baobuibk/SpaceLiinTech_BEE_1012_LDA_HW_V1.1/03_BOM/Satellite_4U_Laser_Int_Ext_V120.xlsx

Name | Description | Designator | Quantity | Library Name | Footprint | Manufacturer 1 | Manufacturer Part Number 1
0.01uF/16V | CAP CER 10000PF 50V X7R 0603 | C1 | 1 | LABLIB.SchLib | CAP_C_1608X80 | Samsung Electro-Mechanics | CL10B103KB8NNNC
0.22uF/25V | CAP CER 0.22UF 25V X7R 0603 | C2, C4, C5, C10, C16, C20, C23, C25, C26, C33, C43, C49, C51, C53, C55, C58, C59, C60 | 18 | LABLIB.SchLib | CAP_C_1608X80 | Samsung Electro-Mechanics | CL10B224KA8NNNC
1k | RES SMD 1K OHM 1% 1/10W 0402 | R1, R5 | 2 | LABLIB.SchLib | RES_C_1005X40 | Panasonic | ERJ2RKF1001X
1k | RES SMD 1K OHM 1% 1/10W 0603 | R25, R26 | 2 | LABLIB.SchLib | RES_C_1608X60 | Panasonic | ERJ-3EKF1001V
1M | RES SMD 1M OHM 1% 1/10W 0402 | R29, R31 | 2 | LABLIB.SchLib | RES_C_1005X40 | Panasonic | ERJ-2RKF1004X
1N4148W-TP | DIODE STANDARD 100V 150MA SOD123 | D10, D11, D12, D13, D14, D15, D16, D17, D18, D19, D20, D21, D22, D23, D24, D25, D26, D27, D28, D29, D30, D31, D32, D33, D36, D37, D38, D39, D40, D41, D42, D43 | 32 | LASER_LIB_SCHE.SchLib | SOD23 | MCC | 1N4148W-TP
3.24k | RES 3.24K OHM 1% 1/16W 0402 | R4 | 1 | LABLIB.SchLib | RES_C_1005X40 | Vishay | CRCW04023K24FKED
4.7k | RES SMD 4.7K OHM 1% 1/10W 0603 | R8, R12, R13, R38, R39, R40, R41, R42, R43, R44, R45, R46, R47 | 13 | LABLIB.SchLib | RES_C_1608X60 | Panasonic | ERJ3EKF4701V
5.1k | RES 5.1K OHM 1% 1/10W 0603 | R28 | 1 | LABLIB.SchLib | RES_C_1608X60 | Yageo Group | RC0603FR-075K1L
7.5k | RES SMD 7.5K OHM 0.1% 1/10W 0603 | R11 | 1 | LABLIB.SchLib | RES_C_1608X60 | Panasonic | ERA3ARB752V
10k | RES SMD 10K OHM 1% 1/10W 0402 | R2, R27, R30 | 3 | LABLIB.SchLib | RES_C_1005X40 | Panasonic | ERJ-2RKF1002X
10k | RES SMD 10K OHM 1% 1/10W 0603 | R9, R16, R18, R23 | 4 | LABLIB.SchLib | RES_C_1608X60 | Panasonic | ERJ-3EKF1002V
10R/1% | RES 10 OHM 1% 1/10W 0603 | R24, R49 | 2 | LASER_LIB_SCHE.SchLib | RES_SMD_0603_SHUNT | Yageo Group | RC0603FR-0710RL
40.2R/1% | RES SMD 40.2 OHM 1% 1/10W 0603 | R48 | 1 | LASER_LIB_SCHE.SchLib | RES_SMD_0603_SHUNT | Panasonic | ERJ3EKF40R2V
47k | RES SMD 47K OHM 1% 1/10W 0603 | R10, R14, R19, R20 | 4 | LABLIB.SchLib | RES_C_1608X60 | Panasonic | ERJ-3EKF4702V
47uF/20V | CAP TANT 47UF 10% 20V 2312 | C3, C6, C17, C18, C19, C21 | 6 | LASER_LIB_SCHE.SchLib | CAP TANT 2312 | KYOCERA AVX | TAJC476K020RNJ
51R/1% | RES SMD 51 OHM 1% 1/10W 0603 | R6, R21 | 2 | LASER_LIB_SCHE.SchLib | RES_SMD_0603_SHUNT | Panasonic | ERJ3EKF51R0V
100k | RES SMD 100K OHM 1% 1/10W 0603 | R7, R17 | 2 | LABLIB.SchLib | RES_C_1608X60 | Panasonic | ERJ3EKF1003V
140R | RES SMD 140 OHM 0.1% 1/10W 0603 | R15, R22 | 2 | LABLIB.SchLib | RES_C_1608X60 | Panasonic | ERA3AEB1400V
221R/1% | RES SMD 221 OHM 1% 1/10W 0603 | R3 | 1 | LASER_LIB_SCHE.SchLib | RES_SMD_0603_SHUNT | Panasonic | ERJ3EKF2210V
470pF/50V | CAP CER 470PF 50V X7R 0603 | C9, C14 | 2 | LABLIB.SchLib | CAP_C_1608X80 | Samsung Electro-Mechanics | CL10B471KB8NNNC
2200pF/50V | CAP CER 2200PF 50V X7R 0603 | C22, C24 | 2 | LABLIB.SchLib | CAP_C_1608X80 | Samsung Electro-Mechanics | CL10B222KB8NNNC
0532611171 | CONN HEADER SMD R/A 11POS 1.25MM | J1, J2 | 2 | LABLIB.SchLib | MOLEX_0532611171 | Molex | 53261-1171
ADG1414BRUZ | IC SW SPST-NOX8 11.5OHM 24TSSOP | U3, U8, U9, U10 | 4 | LASER_LIB_SCHE.SchLib | TSSOP24 | Analog Devices | ADG1414BRUZ
BLM18PG121SN1D | FERRITE BEAD 120 OHM 0603 1LN | FB1, FB2 | 2 | LABLIB.SchLib | IND_C_1608X60 | Murata | BLM18PG121SN1D
CLP-111-02-X-D | CONN RCPT 22POS 0.05 GOLD SMD | J3 | 1 | LASER_LIB_SCHE.SchLib | SAMTEC_CLP-111-02-X-D | Samtec | CLP-111-02-G-D
DMP3098L-7 | DMP3098L-7 | Q1, Q2 | 2 | LASER_LIB_SCHE.SchLib | SOT23-3-132 | Diodes Inc. | DMP3098L-7
hole_space |  | H1, H2, H3, H4, H5, H6, H7, H8 | 8 | IFBschelib.SchLib | HEX-M3_NoVia_Smaller
INA139 | IC CURRENT MONITOR 0.5% SOT23-5 | U4, U6 | 2 | LASER_LIB_SCHE.SchLib | SOT23-5 | Texas Instruments | INA139NA/250
KDZLVTFTR51 | DIODE ZENER 51V 1W SOD123FL | DZ1, DZ2 | 2 | LABLIB.SchLib | SOD3717X145N | ROHM | KDZLVTFTR51
LaserDiode | LASER DIODE 850NM 1.5MW TO46 | LD1, LD2, LD3, LD4, LD5, LD6, LD7, LD8, LD9, LD10, LD11, LD12, LD13, LD14, LD15, LD16, LD17, LD18, LD19, LD20, LD21, LD22, LD23, LD24 | 24 | LASER_LIB_SCHE.SchLib | OPV302 | Optek | OPV302
LaserDiode | 650NM RED SINGLE MODE LASER DIOD | LD25, LD26, LD27, LD28, LD29, LD30, LD31, LD32 | 8 | LASER_LIB_SCHE.SchLib | RLD65NZX1 | ROHM | RLD65NZX1-00A
LED_RED | LED RED CLEAR 0603 SMD | D3 | 1 | LASER_LIB_SCHE.SchLib | LED_0603 | Würth Elektronik Midcom | 150060RS75000
LED_YELLOW | LED YELLOW CLEAR 0603 SMD | D2 | 1 | LASER_LIB_SCHE.SchLib | LED_0603 | Würth Elektronik Midcom | 150060YS75000
MCP4902-E/ST | IC DAC 8BIT 14-TSSOP | U2, U12 | 2 | LASER_LIB_SCHE.SchLib | TSSOP14 | Microchip | MCP4902-E/ST
OPA2192 | IC OPAMP GP 2 CIRCUIT 8SOIC | U5, U7 | 2 | LASER_LIB_SCHE.SchLib | SO8 | Texas Instruments | OPA2192IDR
S2303 | TVS DIODE 3.3VWM 8VC SOT233 | D4, D5, D6, D7, D8, D9, D34, D35, D44 | 9 | LASER_LIB_SCHE.SchLib | SOT23-3-132 | Sangdest Microelectronics | S2303
SRP7050TA-220M | FIXED IND 22UH 2.5A 170 MOHM SMD | L1 | 1 | LABLIB.SchLib | PSM6050 | Bourns | SRP7050TA-220M
SS54 | DIODE SCHOTTKY 40V 5A SMA | D1 | 1 | LABLIB.SchLib | DO-214AC_SMA | Multicomp | SS54
TPS7A4533DCQR | IC REG LIN 3.3V 1.5A SOT-223-6 | U11 | 1 | LASER_LIB_SCHE.SchLib | SOT223-6 | Texas Instruments | TPS7A4533DCQR
TPS5430DDAR | IC REG BUCK ADJ 3A 8SOPWR | U1 | 1 | LASER_LIB_SCHE.SchLib | CONV_TPS5430DDAR | Texas Instruments | TPS5430DDAR
Note |  | Total | 178
Tô vàng: chưa có ở các board trước
Tô hồng: thay thế so với BOM cũ
