baobuibk/SpaceLiinTech_BEE_1012_LDA_HW_V1.1/08_3D/Satellite_4U_Laser_Int_Ext_V130.step

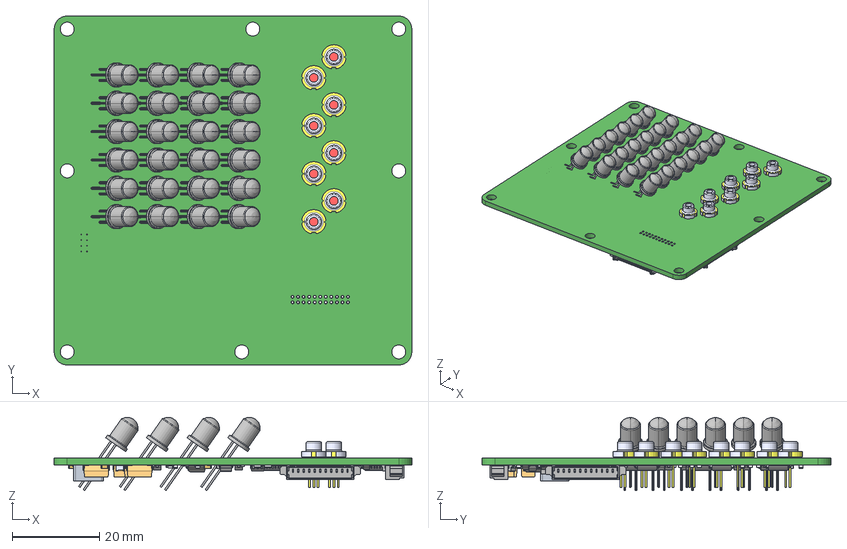
[picture p1: CAD file, 2026-09-09]
08_3D/Satellite_4U_Laser_Int_Ext_V130.step
82.0 x 80.0 x 16.8 mm
RES_0402 x 8
User Library-SMD RESISTOR-1 (3) x 6
532611171_RGB8421504 x 2
Mid Body x 31
Mark x 31
TAJC107K016RNJ x 6
LEAD x 5
LEAD_WIDE
CLP-111-2-G-DTRM
C-106-22-1-G-11_Pin x 2
User Library-IPC SO x 2
SW3DPS-SOT-23-DEFAULT x 11
pin x 32
pin(Mirror) x 32
icbody x 32
Laser diode ML101J25 x 8
SMAJ12A-13-F
User Library-IPC SO_2628500713 x 4
CircuitWorks-SO-8 (PIC12FXXX) x 2
User Library-SOT-23-5_pin_SOT_sot-23-6_1 x 10
User Library-SOT-23-5_body_sot23-6_1 x 2
OPV302_RGB8421504 x 24
SRP7050TA
housing x 2
cover x 2
base x 4
Polarity Mark x 2
