baobuibk/SpaceLiinTech_BEE_1012_LDA_HW_V1.1/(list of files, cad)

Other CAD files:
08_3D/Satellite_4U_Laser_Int_Ext_V12.step
