baobuibk/SpaceLiinTech_BEE_1012_LDA_HW_V1.1/02_Schematic_pdf/Satellite_4U_Laser_Int_Ext_V130.pdf

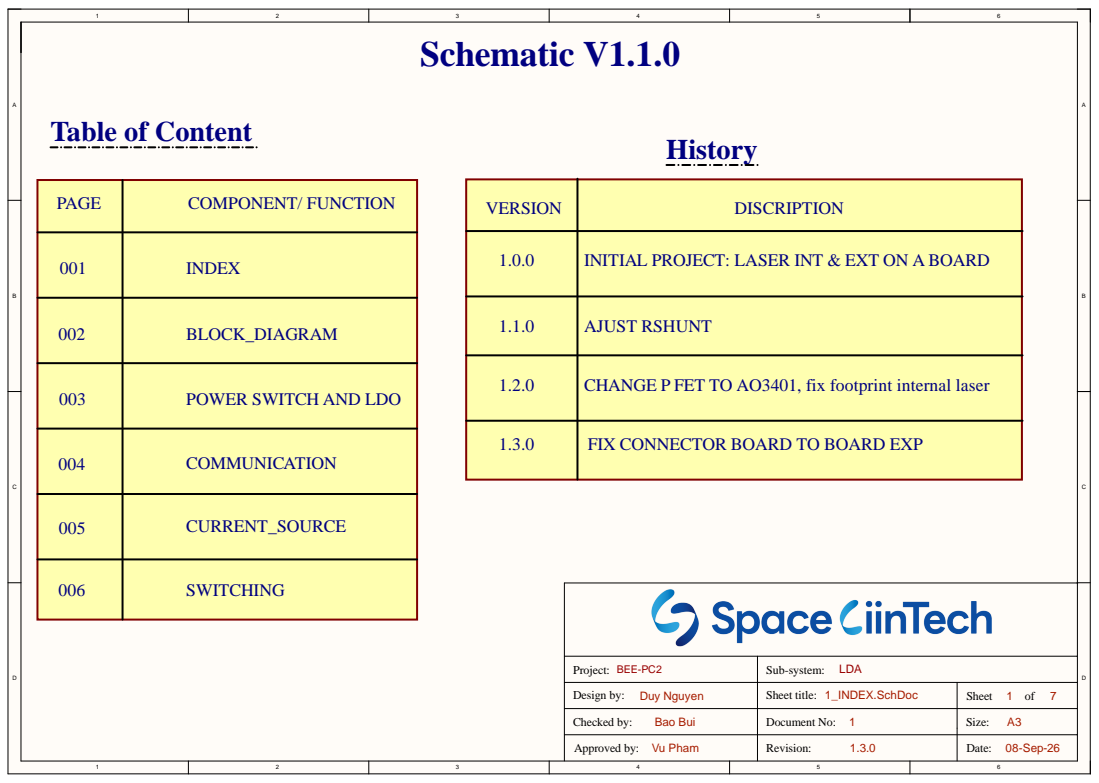
[picture p9: page 1]

INITIAL PROJECT: LASER INT & EXT ON A BOARD

1.2.0 | CHANGE P FET TO AO3401, fix footprint internal laser

003 | POWER SWITCH AND LDO

1.3.0 | FIX CONNECTOR BOARD TO BOARD EXP

004 | COMMUNICATION

005 | CURRENT_SOURCE

006 | SWITCHING

Project: BEE-PC2 | LDA Sub-system:

Design by: Duy Nguyen | Sheet title: 1_INDEX.SchDoc | Sheet 1 of 7

Checked by: Bao Bui | Document No: 1 | Size: A3

Approved by: Vu Pham | Revision: 1.3.0 | Date: 08-Sep-26

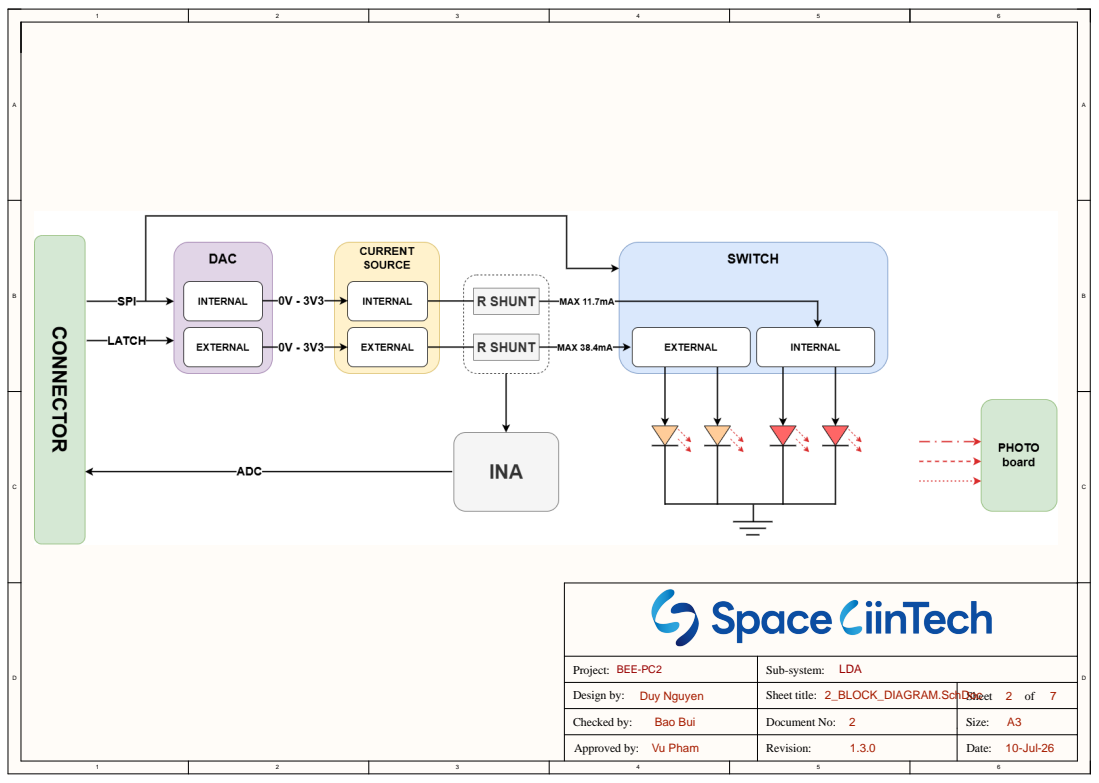
[picture p10: page 2]

BEE-PC2 Project: | LDA Sub-system:

Design by: Duy Nguyen | Sheet title: 2_BLOCK_DIAGRAM.SchDoc | Sheet 2 of 7

Checked by: Bao Bui | Document No: 2 | Size: A3

Date: 10-Jul-26

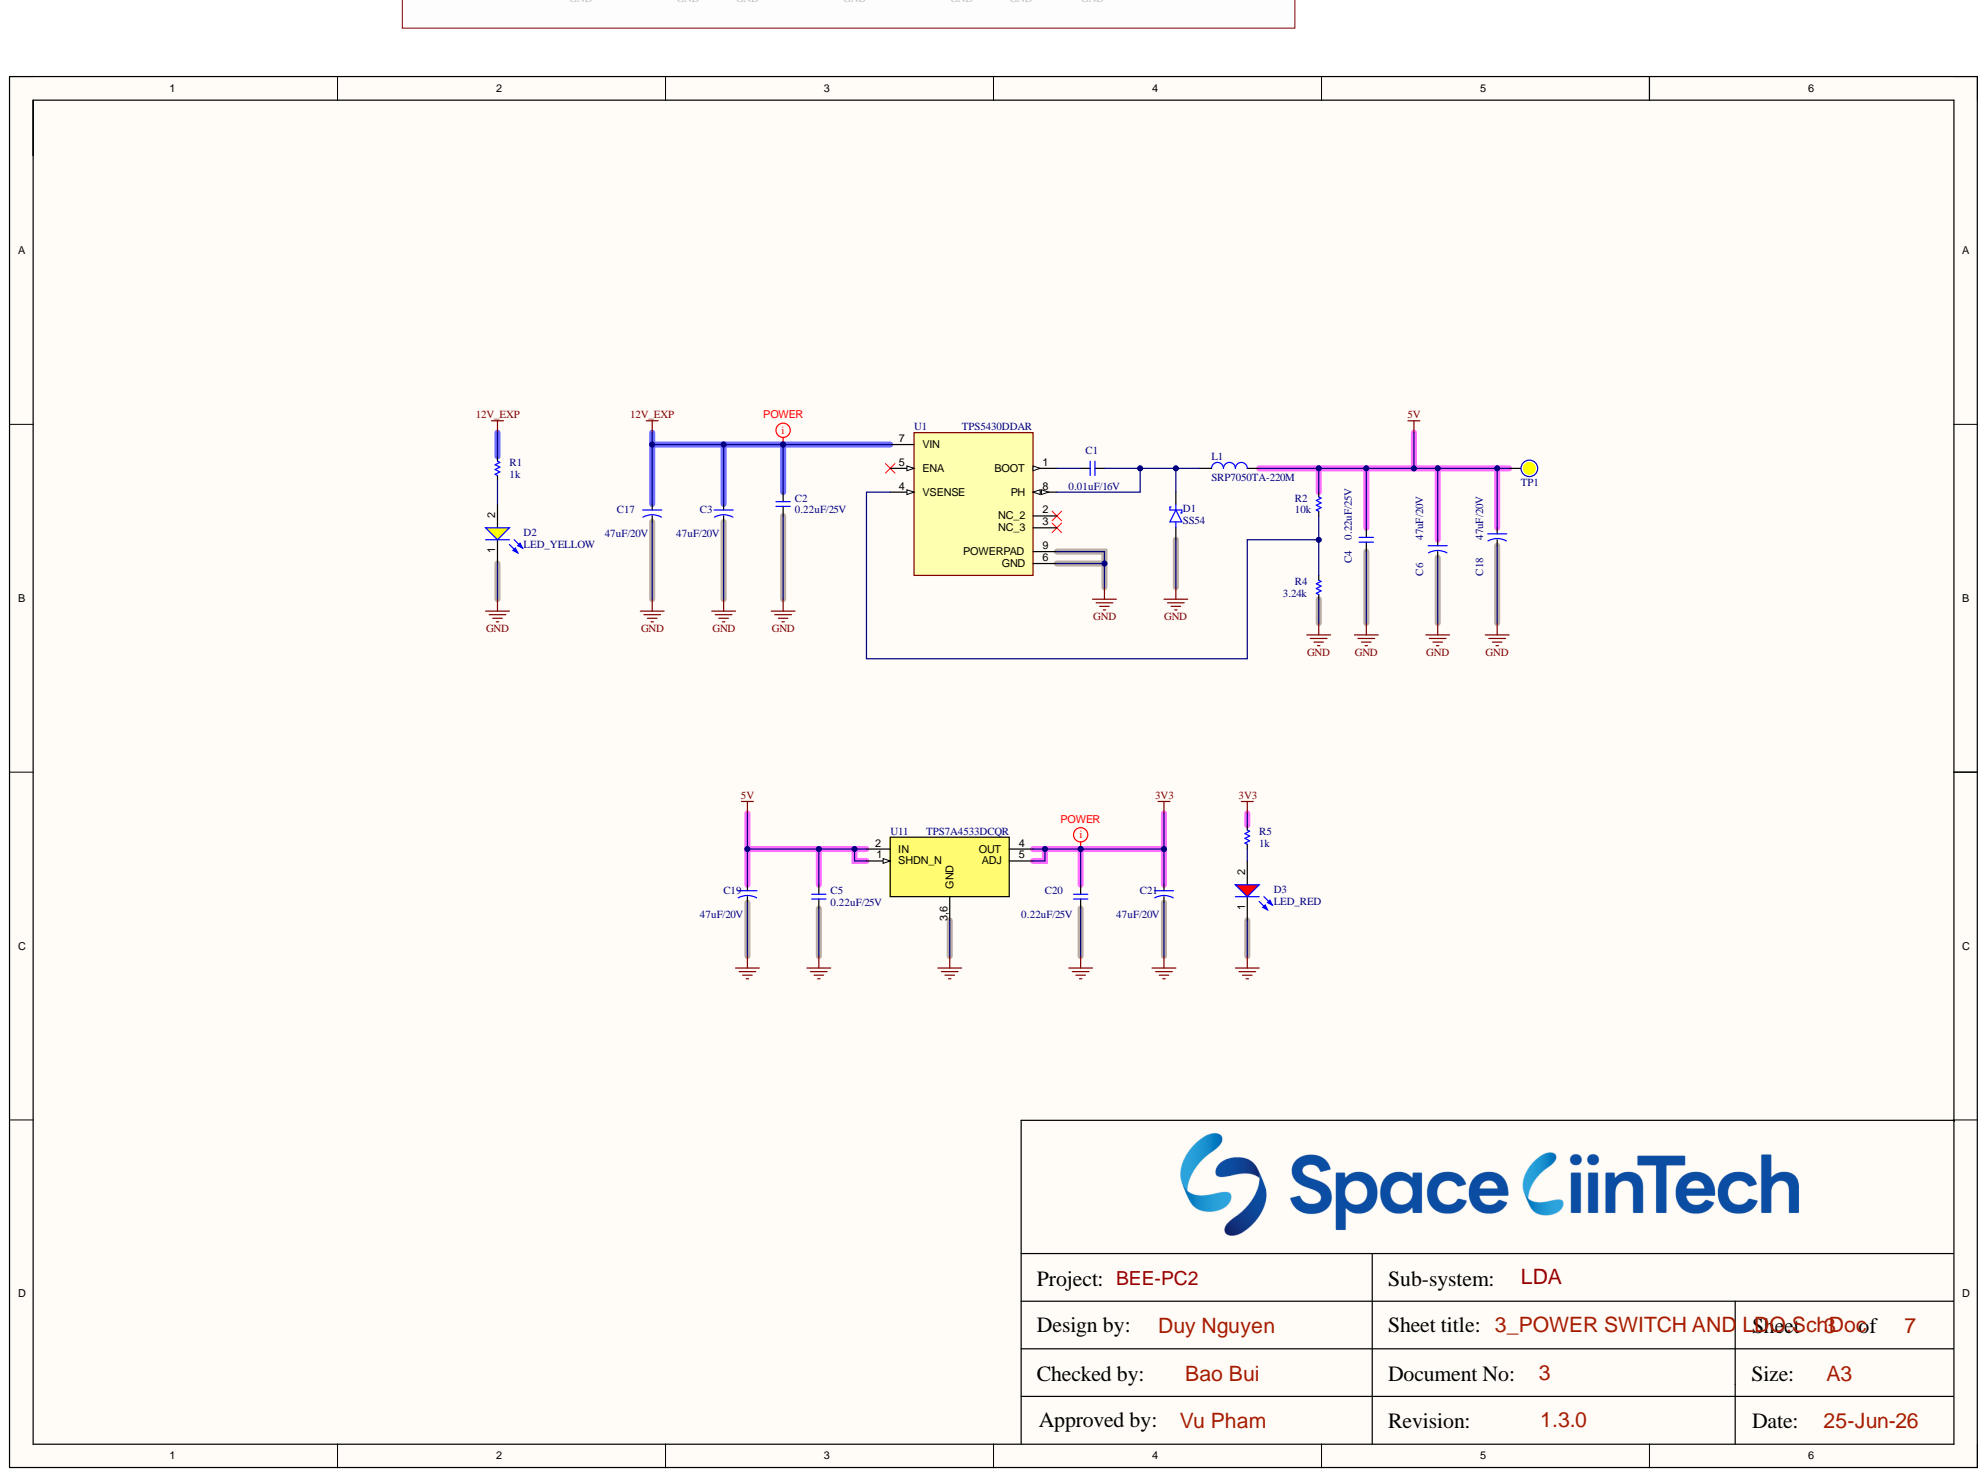
[picture p11: page 3]

Projec t : B E E -PC2 | LDA Sub-syste m :

Design by: Du y Ng u y e n | Sheet title: 3 _POWER SWITCH AND LDO.Sc | Shee t hDo 3 c of 7

Checked by: Ba o Bu i | Document No: 3 | Size : A3

V u Ph a m | Revisio n : 1.3 . | Date : 5-J u n -

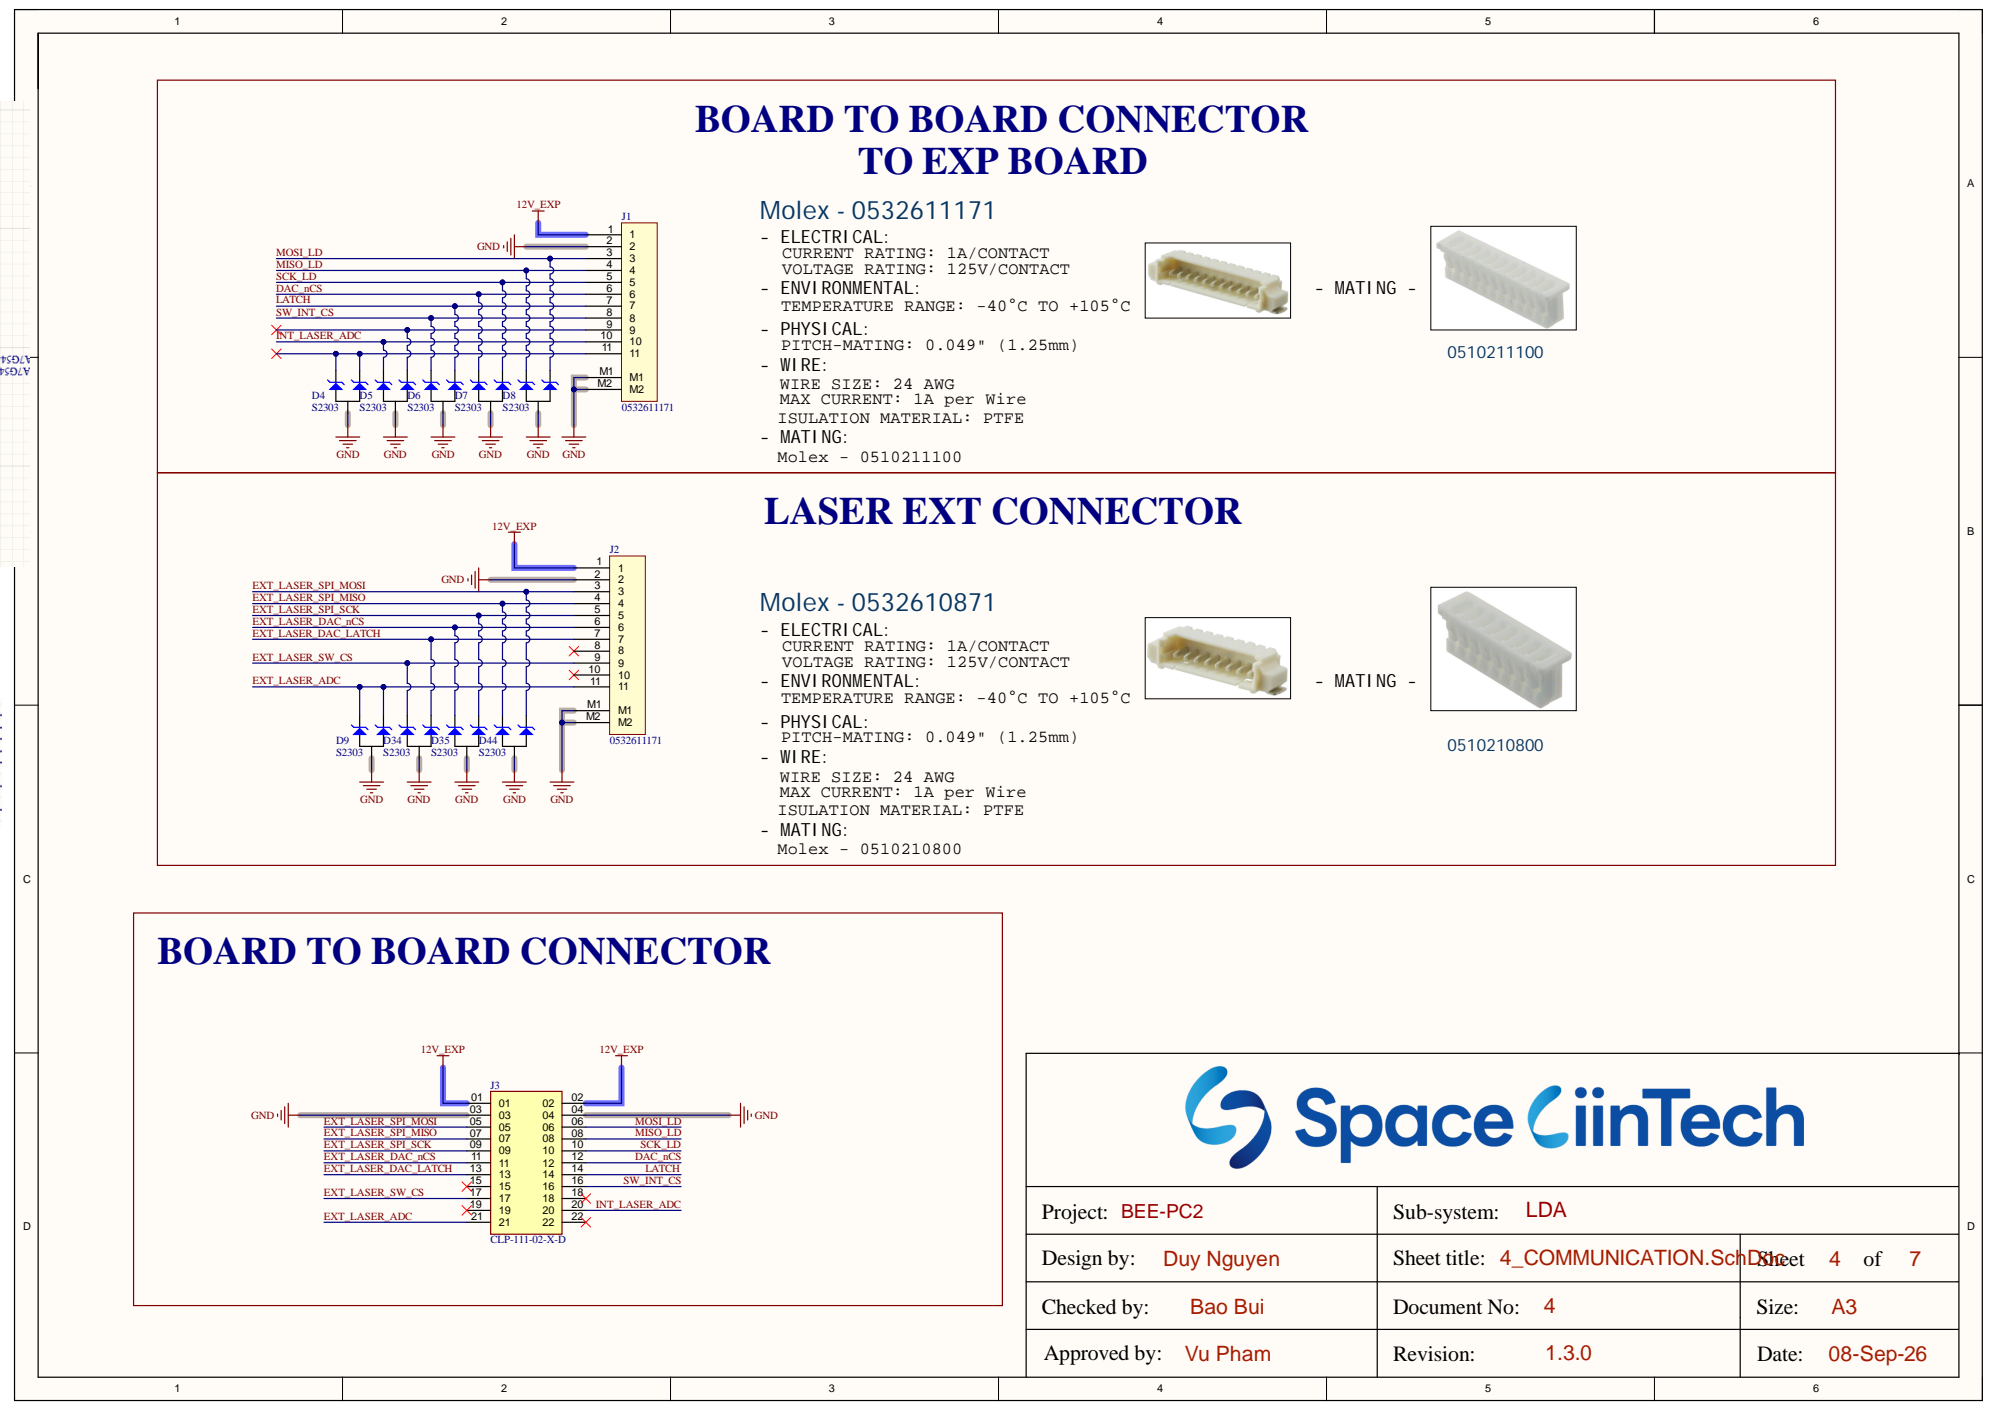
[picture p12: page 4]

BOARD TO BOARD CONNECTOR

Molex - 0532611171 - ELECTRICAL: CURRENT RATING: 1A/CONTACT

VOLTAGE RATING: 125V/CONTACT
- ENVIRONMENTAL: TEMPERATURE RANGE: -40°C TO +105°C

WIRE SIZE: 24 AWG
MAX CURRENT: 1A per Wire
ISULATION MATERIAL: PTFE

Molex - 0532610871 - ELECTRICAL: CURRENT RATING: 1A/CONTACT

- PHYSICAL: PITCH-MATING: 0.049" (1.25mm)
0510210800 - WIRE: WIRE SIZE: 24 AWG

- MATING: Molex - 0510210800

Checked by: Bao Bui | Document No: 4 | Size: A3

Date: 08-Sep-26

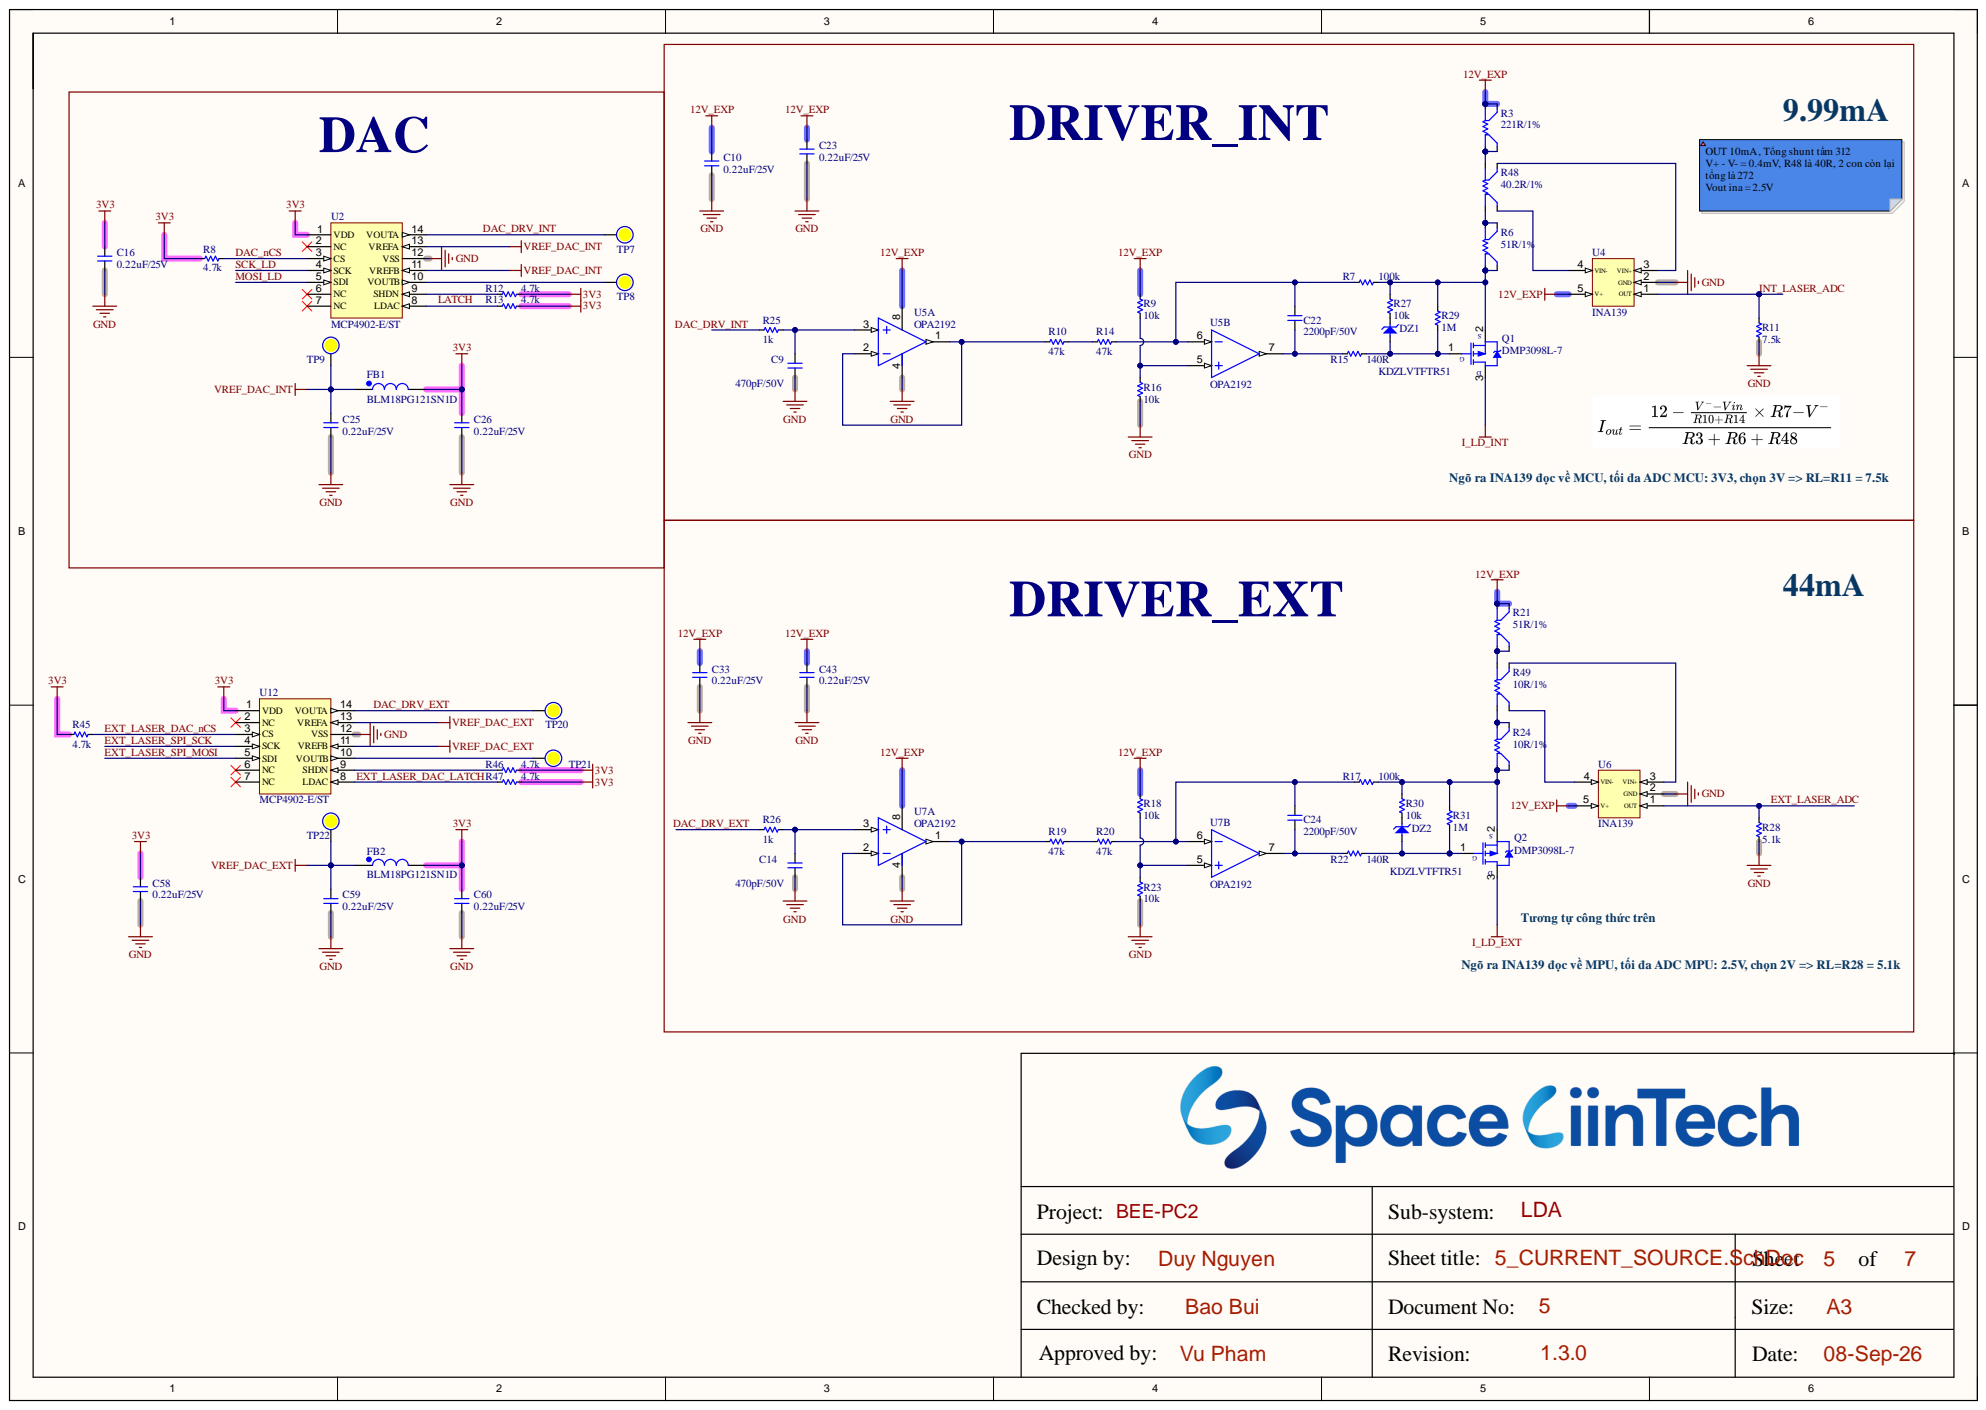
[picture p13: page 5]

OUT 10mA, Tổng shunt tầm 312
V+ - V- = 0.4mV, R48 là 40R, 2 con còn lại
tổng là 272
Vout ina = 2.5V

Ngõ ra INA139 đọc về MCU, tối đa ADC MCU: 3V3, chọn 3V => RL=R11 = 7.5k

Tương tự công thức trên

I_LD_EXT
Ngõ ra INA139 đọc về MPU, tối đa ADC MPU: 2.5V, chọn 2V => RL=R28 = 5.1k

Project: BEE-PC2 | LDA Sub-system:

Design by: Duy Nguyen | Sheet title: 5_CURRENT_SOURCE.SchDoc | Sheet 5 of 7

Checked by: Bao Bui | Document No: 5 | Size: A3

Date: 08-Sep-26

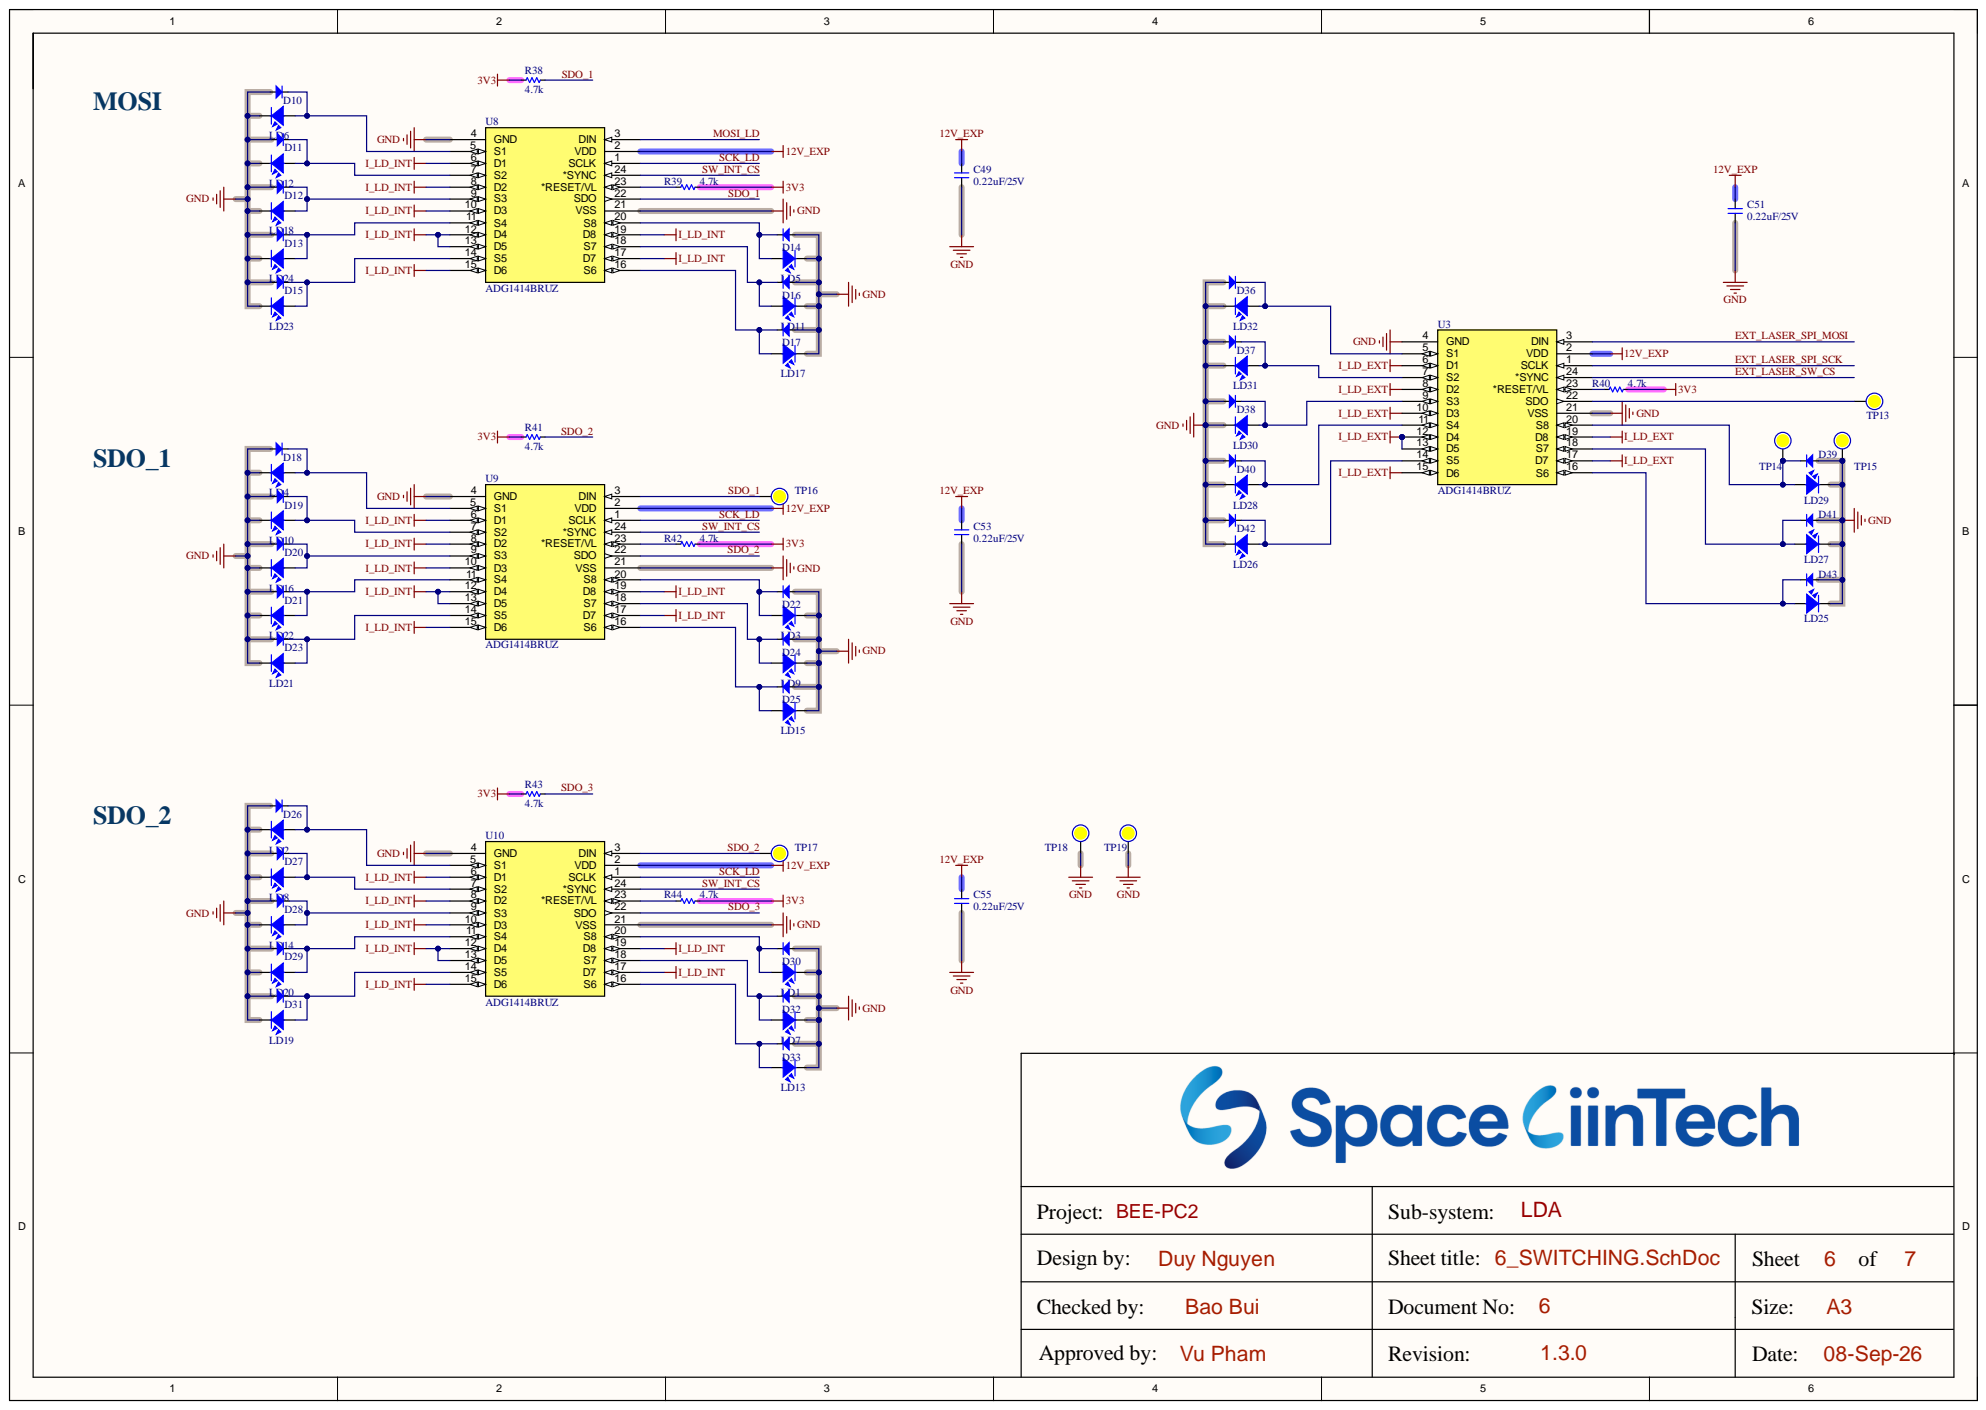
[picture p14: page 6]

7 | SW_INT_C S
8 | | R39 4. 7 k SDO_ 1

7 | | SW_INT_C S
8 | | R44 4. 7 k SDO_ 3

Projec t : B E E -PC2 | LDA Sub-syste m :

Design by: Du y Ng u y e n | Sheet title: 6 _SWITCHING.Sc hDo c | Shee t 6 of 7

Checked by: Ba o Bu i | Document No: 6 | Size : A3

V u Ph a m | Revisio n : 1.3 . | Date : 8-Se p -

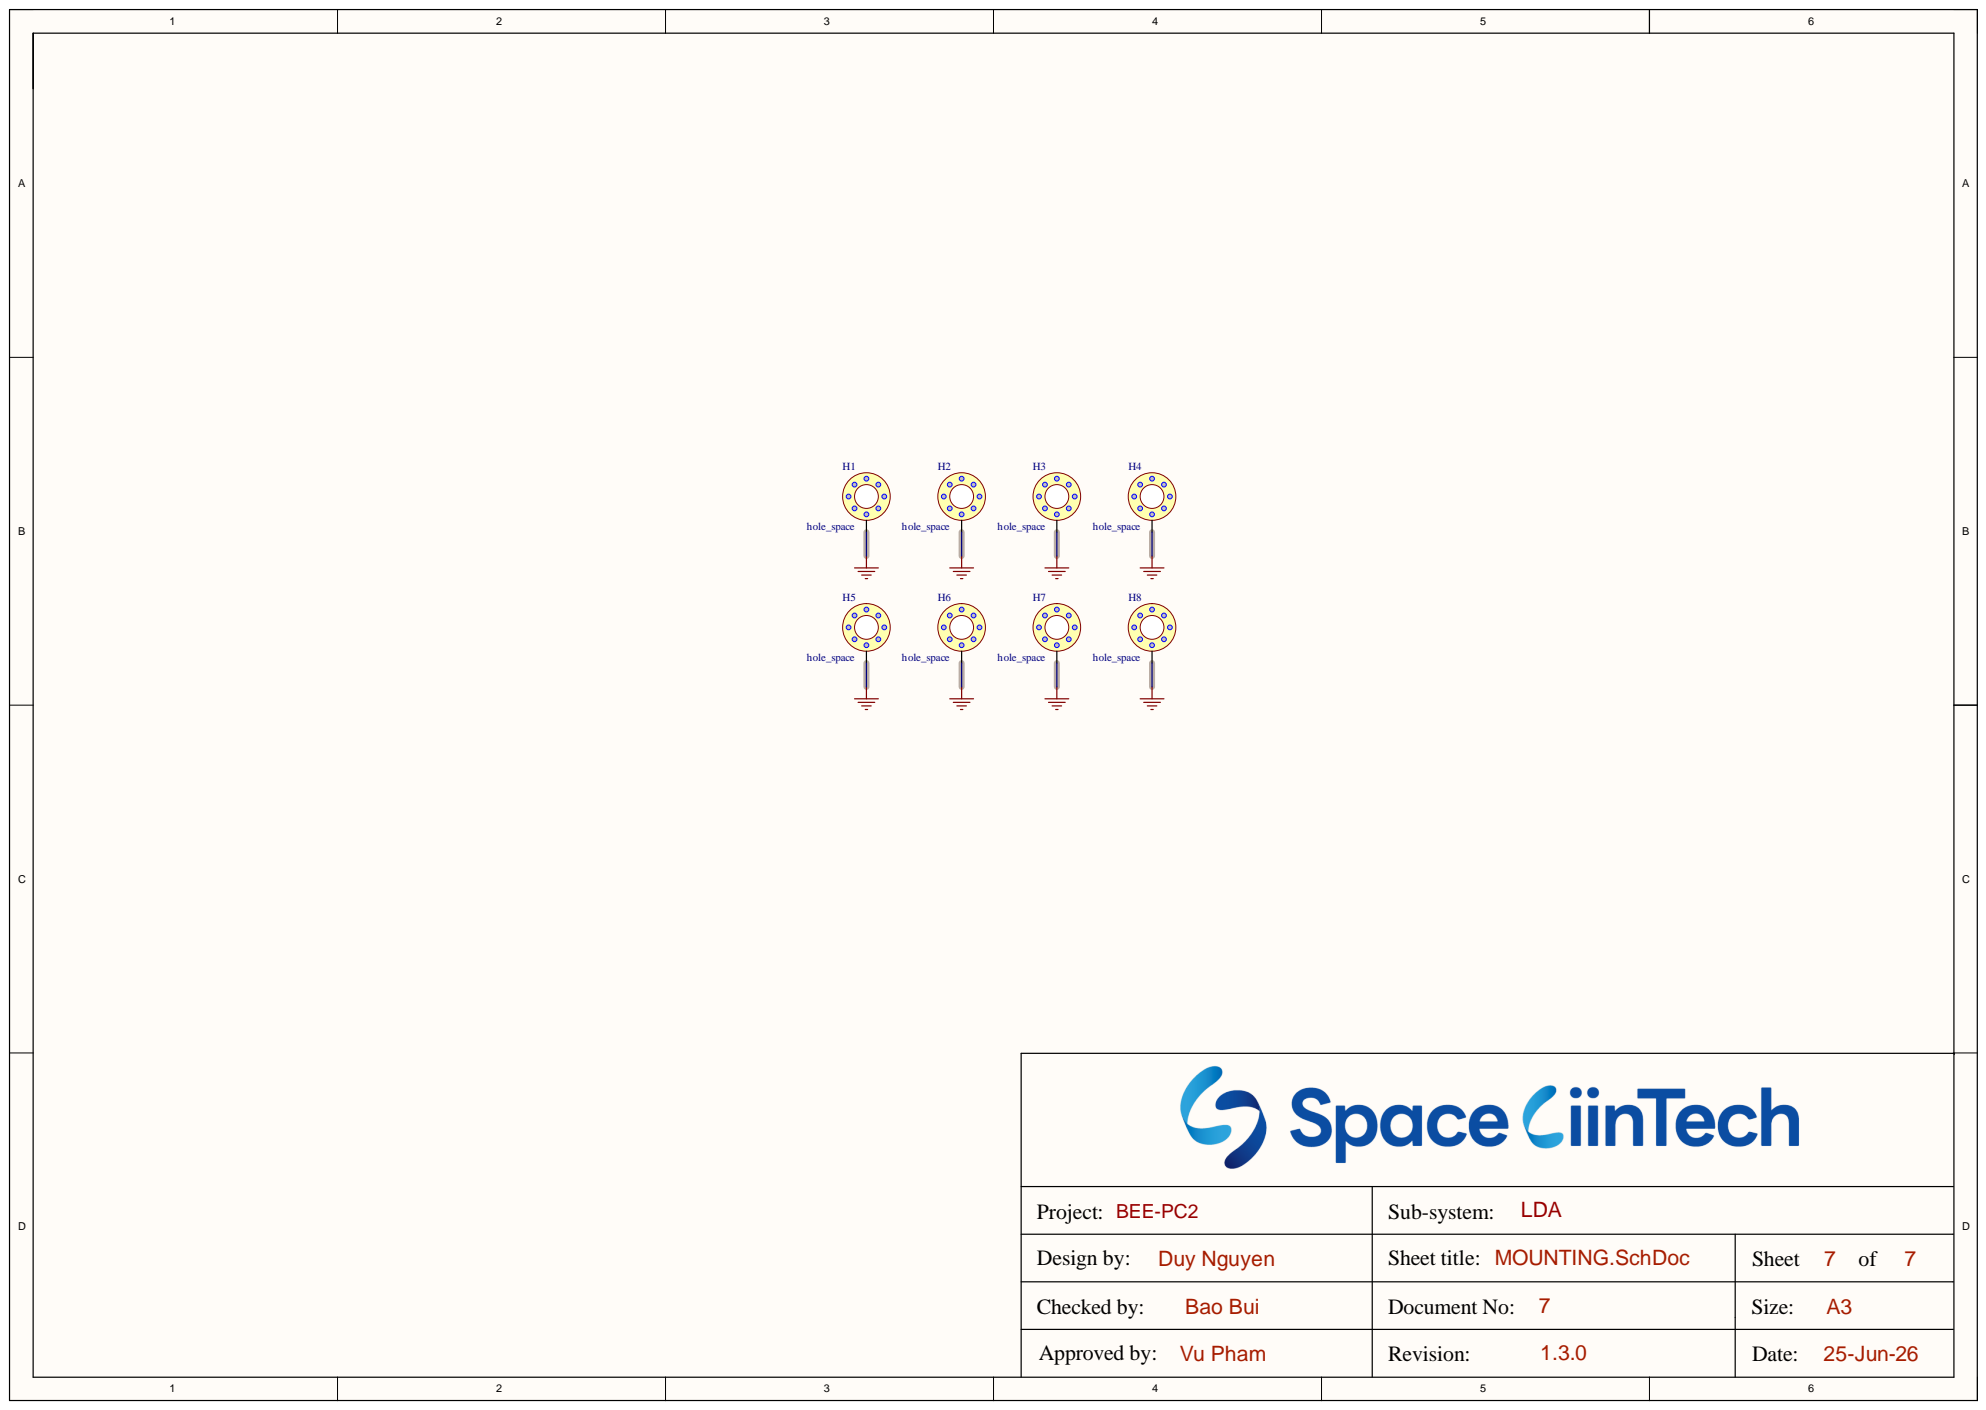
[picture p15: page 7]

Project: BEE-PC2 | LDA Sub-system:

Design by: Duy Nguyen | Sheet title: MOUNTING.SchDoc | Sheet 7 of 7

Checked by: Bao Bui | Document No: 7 | Size: A3

Date: 25-Jun-26

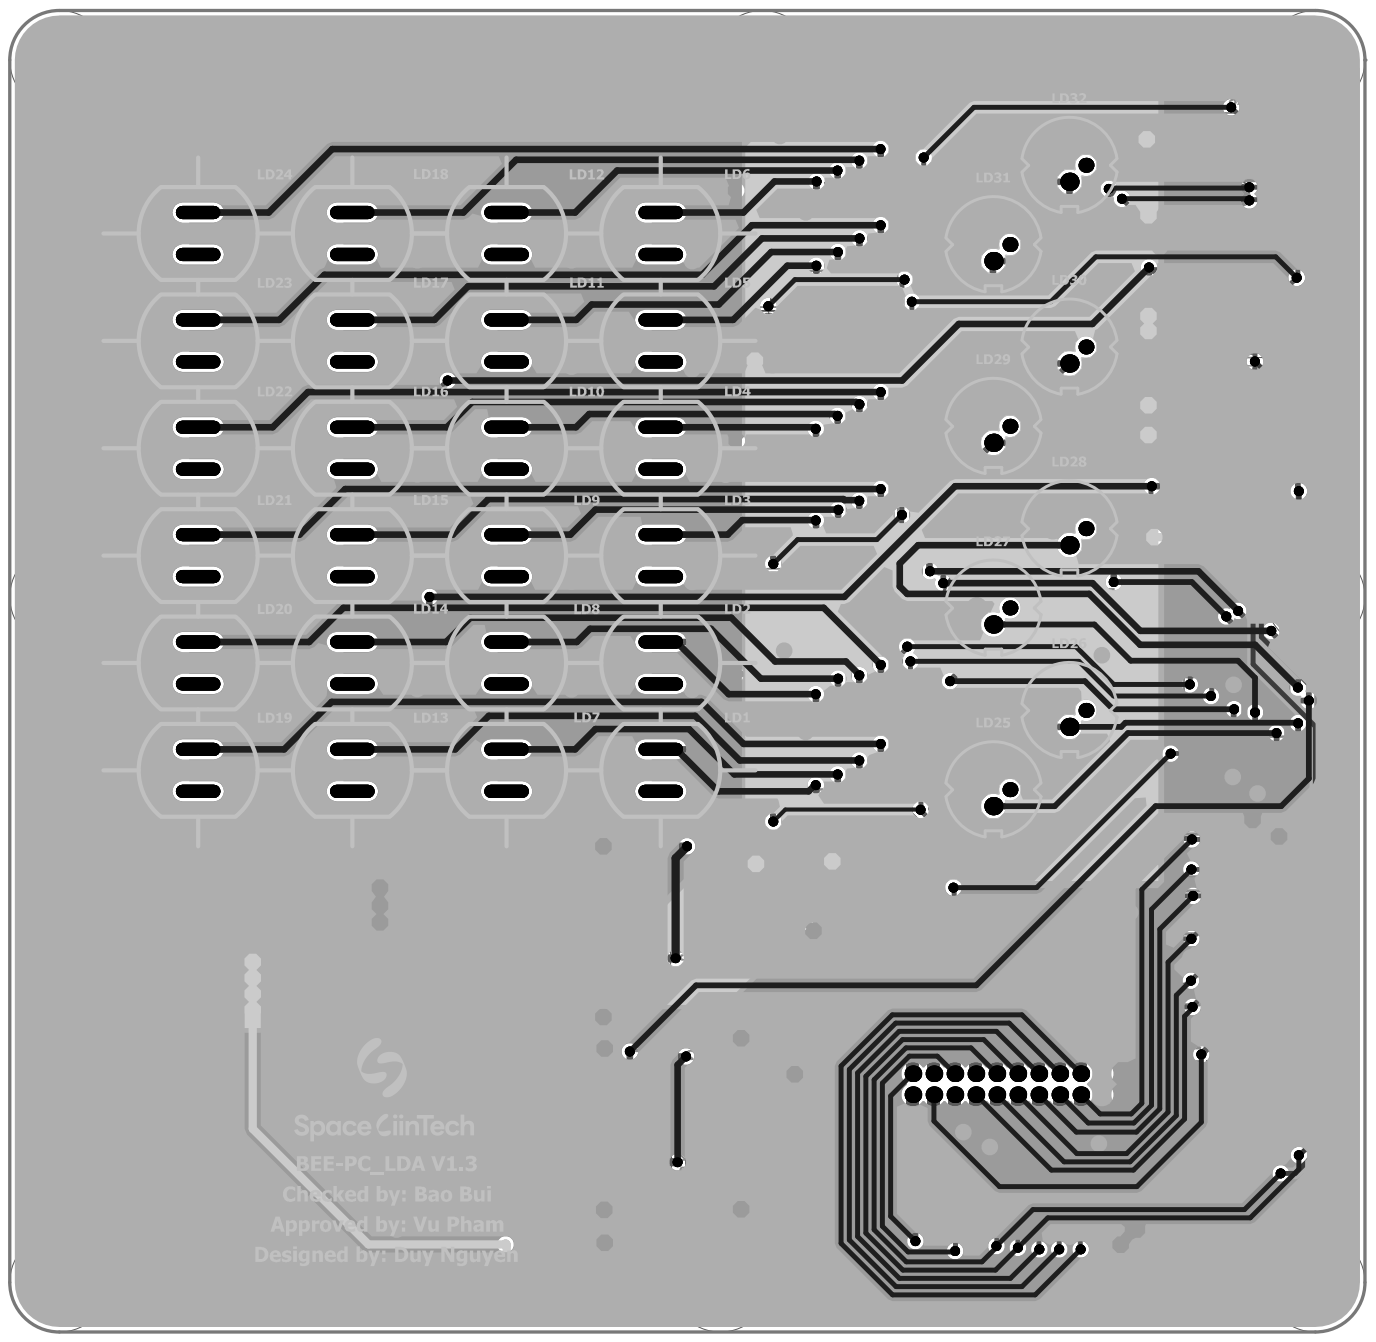
[picture p16: page 8]
