baobuibk/SpaceLiinTech_BEE_1012_LDA_HW_V1.1/05_SMT/Satellite_4U_Laser_Int_Ext_V130_DRAWING_PDF.pdf

A

B

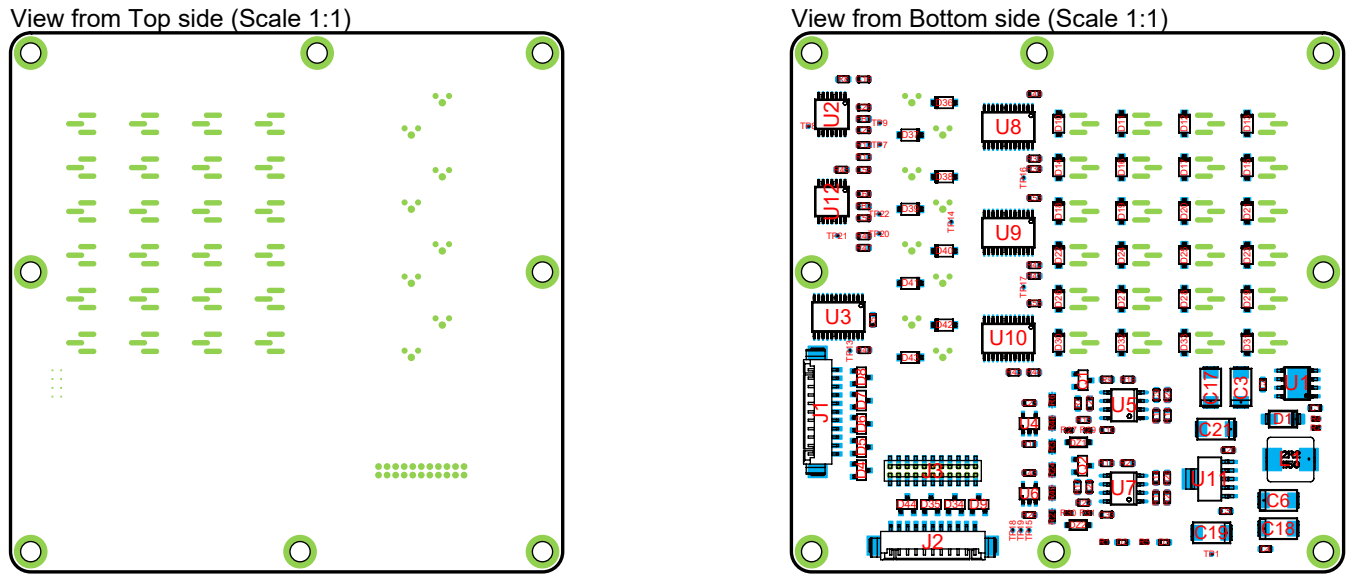
[picture p17: page 1]

View from Top side (Scale 1:1)

View from Bottom side (Scale 1:1)
