baobuibk/SpaceLiinTech_BEE_1012_LDA_HW_V1.1/(list of files, drawings)

Other design files:
01_DESIGN/SpaceLiin_Satellite_4U_Laser_Internal_External_V1.1.0/1_INDEX.SchDoc
01_DESIGN/SpaceLiin_Satellite_4U_Laser_Internal_External_V1.1.0/2_BLOCK_DIAGRAM.SchDoc
01_DESIGN/SpaceLiin_Satellite_4U_Laser_Internal_External_V1.1.0/3_POWER SWITCH AND LDO.SchDoc
01_DESIGN/SpaceLiin_Satellite_4U_Laser_Internal_External_V1.1.0/4_COMMUNICATION.SchDoc
01_DESIGN/SpaceLiin_Satellite_4U_Laser_Internal_External_V1.1.0/5_CURRENT_SOURCE.SchDoc
01_DESIGN/SpaceLiin_Satellite_4U_Laser_Internal_External_V1.1.0/6_SWITCHING.SchDoc
01_DESIGN/SpaceLiin_Satellite_4U_Laser_Internal_External_V1.1.0/MOUNTING.SchDoc
01_DESIGN/SpaceLiin_Satellite_4U_Laser_Internal_External_V1.1.0/REF.PcbDoc
01_DESIGN/SpaceLiin_Satellite_4U_Laser_Internal_External_V1.1.0/Satellite_4U_Laser_Int_Ext_V11.PcbDoc
01_DESIGN/SpaceLiin_Satellite_4U_Laser_Internal_External_V1.1.0/Satellite_4U_Laser_Int_Ext_V110.PrjPcb
09_LIB/LASER_LIB_PCB.PcbLib
09_LIB/LASER_LIB_SCHE.SchLib
