baobuibk/SpaceLiinTech_BEE_1012_LDA_HW_V1.1/(commit log)

2026-06-25 init v110, add a rshunt in each current source
    [1_INDEX.SchDoc, 2_BLOCK_DIAGRAM.SchDoc, 3_POWER SWITCH AND LDO.SchDoc, 4_COMMUNICATION.SchDoc, 5_CURRENT_SOURCE.SchDoc, 6_SWITCHING.SchDoc, LASER_LIB_PCB.PcbLib, LASER_LIB_SCHE.SchLib]
2026-06-25 re-export gerber, pusb BOM, SMT
    [1_INDEX.SchDoc, 2_BLOCK_DIAGRAM.SchDoc, 3_POWER SWITCH AND LDO.SchDoc, 4_COMMUNICATION.SchDoc, 5_CURRENT_SOURCE.SchDoc, 6_SWITCHING.SchDoc, MOUNTING.SchDoc, Pick Place for Satellite_4U_Laser_Int_Ext_V11.csv]
2026-06-25 fix file BOM: add description for 221R
    [Satellite_4U_Laser_Int_Ext_V110.xlsx]
2026-06-25 fix silk: update to BEE-PC_LDAV1.1, re-export: gerber, pick & place, drafman
    [Pick Place for Satellite_4U_Laser_Int_Ext_V11.csv, Satellite_4U_Laser_Int_Ext_V110.PrjPcb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]
2026-07-10 add sche pdf
    [2_BLOCK_DIAGRAM.SchDoc]
2026-08-09 fix footprint internal laser pin 1 and 3 exchange, change part of p mosfet to AO3401
    [5_CURRENT_SOURCE.SchDoc, LASER_LIB_PCB.PcbLib, Satellite_4U_Laser_Int_Ext_V11.PcbDoc, Satellite_4U_Laser_Int_Ext_V110.PrjPcb, Satellite_4U_Laser_Int_Ext_V110.xlsx, Satellite_4U_Laser_Int_Ext_V120.xlsx]
2026-08-09 export gerber, smt file
    [1_INDEX.SchDoc, Pick Place for Satellite_4U_Laser_Int_Ext_V12.csv, Satellite_4U_Laser_Int_Ext_V11.PcbDoc, Satellite_4U_Laser_Int_Ext_V11.step, Satellite_4U_Laser_Int_Ext_V11.xls, Satellite_4U_Laser_Int_Ext_V110.PrjPcb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]
2026-08-09 fix file tracking
    [Satellite_4U_Laser_Int_Ext_V11.PcbDoc]
2026-08-10 fix position of diode at internal laser following to v110
    [Pick Place for Satellite_4U_Laser_Int_Ext_V11.csv, Satellite_4U_Laser_Int_Ext_V11.PcbDoc, Satellite_4U_Laser_Int_Ext_V110.PrjPcb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]
2026-08-11 change part P fet to DMP3098L, add zener and res protection vgs
    [5_CURRENT_SOURCE.SchDoc, Pick Place for Satellite_4U_Laser_Int_Ext_V11.csv, Satellite_4U_Laser_Int_Ext_V11.PcbDoc, Satellite_4U_Laser_Int_Ext_V110.PrjPcb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]
2026-09-08 fix name signal connector EXP in schematic for synchronizing, fix footprint connector EXP detail: swap signals bettween 2 rows
    [1_INDEX.SchDoc, 4_COMMUNICATION.SchDoc, 5_CURRENT_SOURCE.SchDoc, 6_SWITCHING.SchDoc, LASER_LIB_PCB.PcbLib, Pick Place for Satellite_4U_Laser_Int_Ext_V11.csv, Satellite_4U_Laser_Int_Ext_V11.PcbDoc, Satellite_4U_Laser_Int_Ext_V110.PrjPcb]
